nvhhh/sound-proofing/mpp-absorber/mpp_absorber.stl

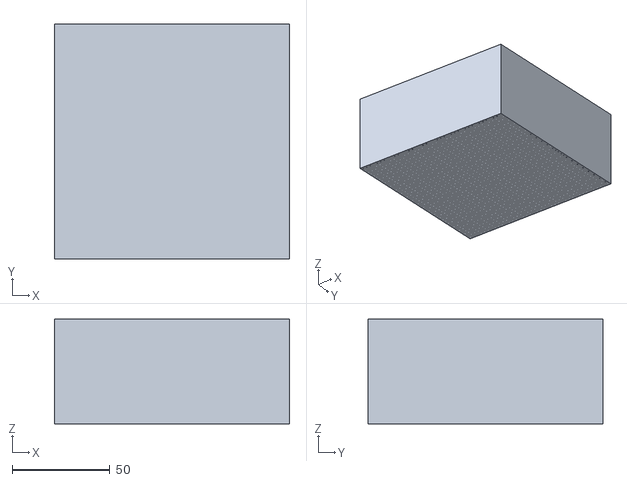
[picture p1: CAD file, 2026-10-27]
mpp-absorber/mpp_absorber.stl
120.0 x 120.0 x 53.6
