nvhhh/sound-proofing/(commit log)

2026-10-27 Add micro-perforated 3D-printable sound absorber proof of concept
    Two-leaf micro-perforated panel (300-3000 Hz) with printable STL,
    normal-incidence model, and interactive wave visualization.
    Claude-Session: https://claude.ai/code/session_01X9tDYGT6FGHZtiTyEZiGbe
    [mpp_absorber.stl]
2026-10-27 Verify MPP model, add field inside stack and exploded view
    - model.py: stack_field() walks pressure and velocity down the stack, giving
    the energy absorbed per leaf and the standing wave in each air gap. Holes
    blocked by ribs can be excluded through open_frac.
    - build_data.py: writes the as-built curve (holes on ribs removed), the leaf
    energy shares and the cavity field; fills template.html into the page.
    - template.html: Explode slider for the five parts, cavity standing-wave
    sheets, per-leaf absorption bars, dashed as-built curve. Fixes the
    perforation ratios (front 2.2%, rear 0.55%), moves the camera outside the
    room slab, and thins the room sheets so they stop saturating the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
2026-10-27 Add parametric stackable absorber tile with screw and tape mounting
    Session: https://claude.ai/code/session_01X9tDYFReQj97VtcshRRmQF
2026-10-27 Show stackable tile and mounting on the visualization page
    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
2026-10-27 Use exact viscous tube impedance; add impedance-tube analysis and tests
    Band mean moves from 0.56 (Maa 1998 fit) to 0.65 with the exact Bessel tube and a 0.85 d end correction. Adds measure.py for two-microphone analysis and tests/ for model and analysis checks.
    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
2026-10-27 Calibrate end correction to 0.68 d; add plate-vibration and printing-material checks
    A resolved 2-D Stokes simulation of one hole gives an end correction of 0.66-0.70 d, not 0.85 d. structure.py checks leaf and rib-wall modes and leaf motion; the leaves stay still in band for PLA, PETG and ABS, and nylon's first mode falls inside the band.
    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
2026-10-27 Best printable design: shared geometry, bench reads design data, updated results
    Search over hole size, pitch, leaf thickness and cavity depths, with printability rules and the exact tube model with 0.68 d end correction. Holes are placed midway between rib centrelines with a 0.4 mm web; the bench, tile and coupon share geometry.py. Session: https://claude.ai/code/session_01X9tDYFReQj97VtcshRRmQF
2026-10-27 Add OpenSCAD test kit and testing methodology
    Impedance-tube sample, rigid reference and hole test strip in OpenSCAD (not yet rendered here; OpenSCAD is not installed in this environment), plus a methods document covering simulation, printing checks, the ISO 10534-2 tube test and room checks. Session: https://claude.ai/code/session_01X9tDYFReQj97VtcshRRmQF
    [mpp_test_kit.scad]
2026-10-27 Room estimate: add 240 mm tile option, record counts and weight
    Tile size is selectable in the room page. The Sabine estimate is per unit area, so reverberation times are unchanged; tile counts, hole counts and weight differ. Session: https://claude.ai/code/session_01X9tDYFReQj97VtcshRRmQF
2026-10-27 Necked rear cells: Helmholtz neck termination, bench shows necked design
    Model: rear cavity can end in a neck (exact tube impedance). Bench design uses 60 mm rear cells with 4 mm bore, 5 mm necks; 120-250 Hz absorption 0.51 vs 0.08 for the previous rigid design. Session: https://claude.ai/code/session_01X9tDYFReQj97VtcshRRmQF
2026-10-27 Count neck power in the energy balance; rebuild bench
    The neck radiates into the wall space; its power is counted as absorbed and the balance test now includes it. Session: https://claude.ai/code/session_01X9tDYFReQj97VtcshRRmQF
2026-10-27 Add plate-mass option for membrane absorbers (exploration)
    stack_field takes plate_mass per leaf. Membrane front gives about 0.47 at 120-250 Hz with a 60 mm rear cell but collapses the mid band; not combined into the tile. Session: https://claude.ai/code/session_01X9tDYFReQj97VtcshRRmQF
2026-10-27 Product line: bass trap, mid-high, low-mid; 240 mm bed mix; bench and room page use them
    products.py defines the three 120 mm products and the best 240 mm bed mix (maximin over 125 Hz to 4 kHz). Bench shows the product table; room page selects a product or the mix. Session: https://claude.ai/code/session_01X9tDYFReQj97VtcshRRmQF
2026-10-27 Rework methodology: evidence levels, slot model, validation tests, robustness check
    Adds wide-slit slot model (approximate, reproduces the report's bass face only partly), exact-limit tests, a seeded robustness check over end correction and cavity depth, and METHODOLOGY.md with evidence levels and measurement gates. Two earlier test expectations were wrong and are corrected. Session: https://claude.ai/code/session_01X9tDYFReQj97VtcshRRmQF
2026-10-27 Rerun proposed designs under the new methodology
    rerun_models.py evaluates the bench design, the three products, the bed mix, the SCAD bass face (approximate slot model) and a foam option (assumed resistivity), with octave bands, a seeded robustness score and an evidence level. Fixed an impedance inversion in the foam option; added a test that the foam stack reduces to air at low resistivity. Session: https://claude.ai/code/session_01X9tDYFReQj97VtcshRRmQF
2026-10-27 Run absorbers.scad through the methodology: bass face and HF channel bank
    scad_check.py models the bass slot face (A) and an approximate HF channel bank (A, rough: no mouth end correction or coupling). On the target bands: bass 125-250 Hz 0.80 (report 0.866), HF 500-4000 Hz 0.89 (report 0.895, close but not validated). Methodology now scores targets on linear bands. Session: https://claude.ai/code/session_01X9tDYFReQj97VtcshRRmQF
2026-10-27 Check hybrid 200 mm SCAD: geometry re-checks and acoustic model
    hybrid_check.py re-runs the file's assertions in Python (OpenSCAD is not installed here) and models 4 resonator tunings and 8 channel tunings with the slit and channel models (A, rough). Session: https://claude.ai/code/session_01X9tDYFReQj97VtcshRRmQF
